OpenRemise/S3Main/README.md

# S3Main



<a href="https://openremise.at">
<picture>
  <source media="(prefers-color-scheme: dark)" srcset="https://github.com/OpenRemise/.github/raw/master/data/icons/icon_dark.svg">
  
</picture>
</a>

The S3Main is the first officially supported [OpenRemise](https://openremise.at) board.

### Features
- WiFi-capable ESP32-S3 SoC
- 10-22V DC supply
- Reverse polarity protection
- Single track output
- Adjustable current limits 0.5, 1.3, 2.7 and 4.1A
- [SUSI](https://normen.railcommunity.de/RCN-600.pdf) interface
- USB-C interface
- RailCom detector
