OpenRemise/S3Main/bom.xlsx

 |  |  | S3Main PCS BOM
Item # | *Designator | *Qty | Manufacturer | *Mfg Part # | Description / Value | *Package/Footprint | Type | Your Instructions / Notes
1 | C1,C2,C3,C7,C8,C11,C18,C29,C30,C31 | 10 | Samsung Electro-Mechanics | CL05B104KB54PNC | CAP CER 0.1UF 50V X7R 0402 | 0402 | SMD
2 | C4,C6,C19,C21,C22,C25,C26,C34 | 8 | Murata Electronics | GRM1555C2A102JE01D | CAP CER 1000PF 100V C0G/NP0 0402 | 0402 | SMD
3 | C5,C35,C36 | 3 | Murata Electronics | GCM1555C1H221JA16D | CAP CER 220PF 50V C0G/NP0 0402 | 0402 | SMD
4 | C9,C10 | 2 | Murata Electronics | GCM1555C1H101JA16D | CAP CER 100PF 50V C0G/NP0 0402 | 0402 | SMD
5 | C12,C20,C27 | 3 | Cornell Dubilier Knowles | ATB107M035E077 | CAP ALUM 100UF 20% 35V SMD | 6.60x6.60mm | SMD
6 | C13 | 1 | Murata Electronics | GRM31MR72A474KA35L | CAP CER 0.47UF 100V X7R 1206 | 1206 | SMD
7 | C14 | 1 | Samsung Electro-Mechanics | CL31B106KBHNNNE | CAP CER 10UF 50V X7R 1206 | 1206 | SMD
8 | C15,C16,C17,C23,C24 | 5 | Samsung Electro-Mechanics | CL31B105KCHVPJE | CAP CER 1UF 100V X7R 1206 | 1206 | SMD
9 | C28 | 1 | Samsung Electro-Mechanics | CL31B475KBHNFNE | CAP CER 4.7UF 50V X7R 1206 | 1206 | SMD
10 | C32 | 1 | Murata Electronics | GRT3195C2A103JA02D | CAP CER 10000PF 100V C0G 1206 | 1206 | SMD
11 | C33,C37 | 2 | TDK Corporation | C3216X7S0J476M160AC | CAP CER 47UF 6.3V X7S 1206 | 1206 | SMD
12 | D1,D2,D3,D7,D8,D11,D13,D16,D17,D19 | 10 | onsemi | 1N4148WT | SMALL SIGNAL DIODE SOD523 100V | SOD-523 | SMD
13 | D4 | 1 | SunLED | XZVG68W-2 | LED GREEN CLEAR CHIP SMD | 0402 | SMD
14 | D5 | 1 | SunLED | XZMDK68W-2 | LED RED CLEAR CHIP SMD | 0402 | SMD
15 | D6 | 1 | SunLED | XZFBA68W5MAV-3 | LED BLUE CLEAR 0402 SMD | 0402 | SMD
16 | D9 | 1 | Diotec Semiconductor | BZX84C15 | DIODE ZENER 15V 300W SOT23-3 | SOT-23-3 | SMD
17 | D10 | 1 | STMicroelectronics | ESDA6V1BC6 | TVS DIODE 5VWM SOT23-6 | SOT-23-6 | SMD
18 | D12 | 1 | Toshiba Semiconductor and Storage | CEZ30V,L3F | TVS DIODE 30VWM 47.5VC ESC | SOD-523 | SMD
19 | D14,D15 | 2 | Shenzhen Slkormicro Semicon Co., Ltd. | B5819W | 40V INDEPENDENT TYPE 900MV@3A 1A | SOD-123 | SMD
20 | D18 | 1 | Diodes Incorporated | SBR3U60P1-7 | DIODE SBR 60V 3A POWERDI123 | PowerDI™ 123 | SMD
21 | J1 | 1 | Phoenix Contact | 1844210 | TERM BLOCK HDR 2POS 90DEG 3.5MM |  | THT
22 | J2 | 1 | CNC Tech | 3020-40-0300-00 | CONN HEADER SMD 40POS 2.54MM |  | SMD
23 | J3 | 1 | Phoenix Contact | 1836189 | TERM BLOCK HDR 2POS 90DEG 5.08MM |  | THT
24 | J4 | 1 | GCT | USB4105-GF-A-120 | CONN RCP USB2.0 TYP C 24P SMD RA |  | SMD
25 | J5 | 1 | JST Sales America Inc. | SM04B-SRSS-TB | CONN HEADER SMD R/A 4POS 1MM |  | SMD
26 | L1 | 1 | Murata Electronics | LQM21PN4R7NGRD | FIXED IND 4.7UH 800MA 288MOHM SM | 0805 | SMD
27 | Q1,Q6 | 2 | Rohm Semiconductor | QS6K21TR | MOSFET 2N-CH 45V 1A TSMT6 | TSOT-23-6 | SMD
28 | Q2 | 1 | onsemi | BC847BDW1T1G | TRANS 2NPN 45V 0.1A SC88/SC70-6 | SOT-363 | SMD
29 | Q3,Q4,Q5,Q7,Q8 | 5 | Vishay Siliconix | SIS4634LDN-T1-GE3 | N-CHANNEL 60 V (D-S) MOSFET POWE | PowerPAK® 1212-8 | SMD
30 | Q9 | 1 | ANBON SEMICONDUCTOR (INT'L) LIMITED | BC847B | PLASTIC ENCAPSULATE TRANSISTORS | SOT-23-3 | SMD
31 | Q10 | 1 | onsemi | BSS138 | MOSFET N-CH 50V 220MA SOT23-3 | SOT-23-3 | SMD
32 | R1,R8,R18,R20,R34,R35,R36,R43,R50,R54 | 10 | YAGEO | RC0402FR-0710KL | RES 10K OHM 1% 1/16W 0402 | 0402 | SMD
33 | R2,R3,R4,R5 | 4 | YAGEO | RC0402FR-0722KL | RES 22K OHM 1% 1/16W 0402 | 0402 | SMD
34 | R6,R7,R31,R51 | 4 | YAGEO | RC0402FR-074K7L | RES 4.7K OHM 1% 1/16W 0402 | 0402 | SMD
35 | R9 | 1 | Vishay Dale | RCS08052R20FKEA | RES SMD 2.2 OHM 1% 1/2W 0805 | 0805 | SMD
36 | R10,R11,R14,R32,R45,R55 | 6 | YAGEO | RC0402FR-071KL | RES 1K OHM 1% 1/16W 0402 | 0402 | SMD
37 | R12,R13,R22,R26,R27 | 5 | YAGEO | RC0402FR-073K3L | RES 3.3K OHM 1% 1/16W 0402 | 0402 | SMD
38 | R15,R16,R52,R53 | 4 | YAGEO | RC0402FR-0733RL | RES 33 OHM 1% 1/16W 0402 | 0402 | SMD
39 | R17 | 1 | YAGEO | RC0402FR-07220RL | RES 220 OHM 1% 1/16W 0402 | 0402 | SMD
40 | R19,R57 | 2 |  |  |  | DNP | DNP
41 | R21 | 1 | YAGEO | RC0402FR-07100KL | RES 100K OHM 1% 1/16W 0402 | 0402 | SMD
42 | R23 | 1 | YAGEO | RC0402FR-07562RL | RES 562 OHM 1% 1/16W 0402 | 0402 | SMD
43 | R24,R25 | 2 |  |  |  | DNP | DNP
44 | R28 | 1 | YAGEO | RC0402FR-07422RL | RES 422 OHM 1% 1/16W 0402 | 0402 | SMD
45 | R29,R30,R46,R49 | 4 | YAGEO | RC0402FR-0747RL | RES 47 OHM 1% 1/16W 0402 | 0402 | SMD
46 | R33 | 1 | YAGEO | RC0402FR-07180RL | RES 180 OHM 1% 1/16W 0402 | 0402 | SMD
47 | R37,R44,R47 | 3 | YAGEO | RC0402FR-0714K3L | RES 14.3K OHM 1% 1/16W 0402 | 0402 | SMD
48 | R38,R48 | 2 | YAGEO | RC0402FR-07470RL | RES 470 OHM 1% 1/16W 0402 | 0402 | SMD
49 | R39 | 1 | YAGEO | RC0402FR-0718K7L | RES 18.7K OHM 1% 1/16W 0402 | 0402 | SMD
50 | R40,R41 | 2 | YAGEO | RC0402FR-075K1L | RES 5.1K OHM 1% 1/16W 0402 | 0402 | SMD
51 | R42 | 1 | YAGEO | RC0402FR-0739KL | RES 39K OHM 1% 1/16W 0402 | 0402 | SMD
52 | R56 | 1 | Panasonic Electronic Components | ERJ-PA2J221X | RES 220 OHM 5% 1/4W 0402 | 0402 | SMD
53 | SW1, SW2 | 2 | Panasonic Electronic Components | EVP-BFAC1A000 | SWITCH TACTILE SPST-NO 0.02A 15V | 6.00x6.00mm | SMD
54 | U1 | 1 | onsemi | LM393EDR2G | IC COMPARATOR 2 GEN PUR 8SOIC | 8-SOIC | SMD
55 | U2 | 1 | Nexperia USA Inc. | 74LVC02APW,118 | IC GATE NOR 4CH 2-INP 14TSSOP | 14-TSSOP | SMD
56 | U3 | 1 | Texas Instruments | TLV9051IDBVR | IC OPAMP GP 1 CIRCUIT SOT23-5 | SOT23-5 | SMD
57 | U4 | 1 | Espressif Systems | ESP32-S3-WROOM-2-N32R16V | RF TXRX MOD BT WIFI PCB TH SMD |  | SMD
58 | U5 | 1 | Texas Instruments | DRV8328BRUYR | 60 V 1000/2000 MA 3-PHASE GATE D | 28-WQFN | SMD
59 | U6 | 1 | Texas Instruments | TPS281C100ADNTR | 6-V TO 60-V, 100-M, 4.5-A SINGLE | 12-WSON | SMD
60 | U7 | 1 | Diodes Incorporated | AP63205WU-7 | IC REG BUCK 5V 2A TSOT23-6 | SOT-23-6 | SMD
61 | U8 | 1 | Texas Instruments | TXS0102DCTR | IC TRANSLATOR BIDIRECTIONAL SM8 | 8-SSOP | SMD
62 | U9 | 1 | Diodes Incorporated | AZ1117CR-3.3TRG1 | IC REG LINEAR 3.3V 1A SOT89 | SOT-89-3 | SMD
63 | U10 | 1 | Infineon Technologies | BTS4141NHUMA1 | IC PWR SWTCH N-CHAN 1:1 SOT223-4 | SOT223-4 | SMD
