OpenRemise/S3Main/s3main.kicad_pcb

## KiCad design s3main.kicad_pcb (2026-06-04)

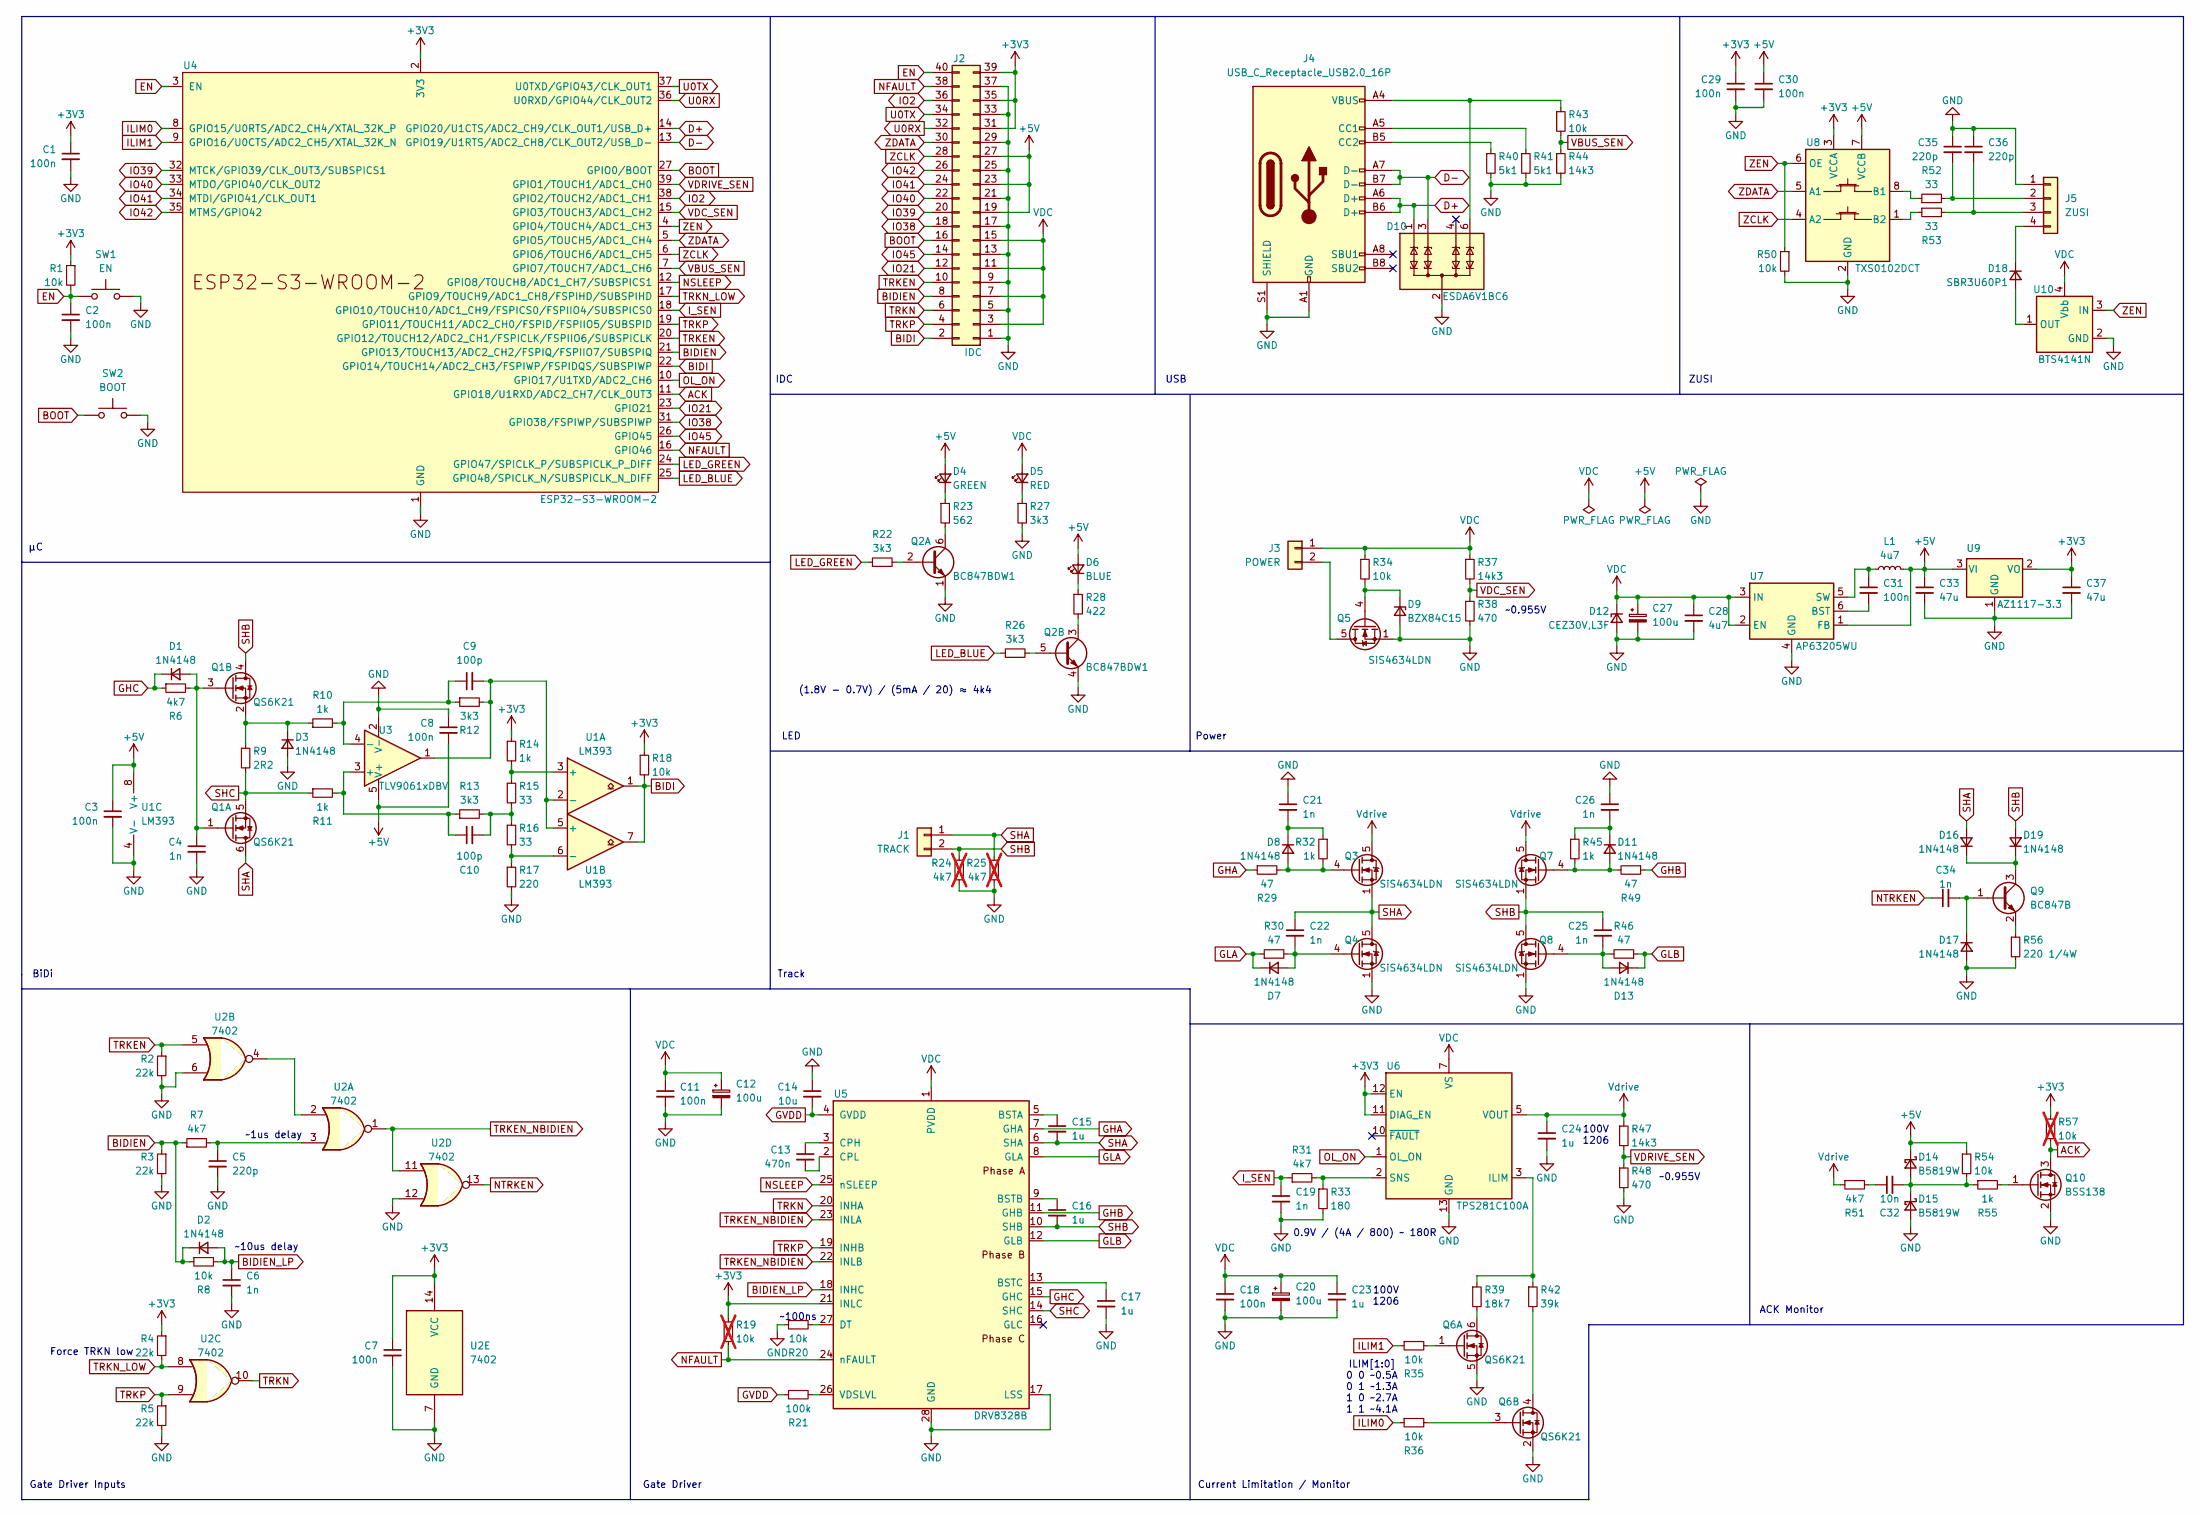
[picture p1: schematic s3main.kicad_sch]

Parts:
C1, C2, C3, C7, C8, C11, C18, C29, C30, C31: 100n; C_0402_1005Metric
C4, C6, C19, C21, C22, C25, C26, C34: 1n; C_0402_1005Metric
C5, C35, C36: 220p; C_0402_1005Metric
C9, C10: 100p; C_0402_1005Metric
C12, C20, C27: 100u; CP_Elec_6.3x7.7
C13: 470n; C_1206_3216Metric
C14: 10u; C_1206_3216Metric
C15, C16, C17, C23, C24: 1u; C_1206_3216Metric
C28: 4u7; C_1206_3216Metric
C32: 10n; C_1206_3216Metric
C33, C37: 47u; C_1206_3216Metric
D1, D2, D3, D7, D8, D11, D13, D16, D17, D19: 1N4148; D_SOD-523
D4: GREEN; D_0402_1005Metric
D5: RED; D_0402_1005Metric
D6: BLUE; D_0402_1005Metric
D9: BZX84C15; SOT-23
D10: ESDA6V1BC6; SOT-23-6
D12: CEZ30V,L3F; D_SOD-523
D14, D15: B5819W; D_SOD-123
D18: SBR3U60P1; D_PowerDI-123
J1: TRACK; PhoenixContact_MC_1,5_2-G-3.5_1x02_P3.50mm_Horizontal
J2: IDC; IDC-Header_2x20_P2.54mm_Vertical_SMD
J3: POWER; PhoenixContact_MC_1,5_2-G-5.08_1x02_P5.08mm_Horizontal
J4: USB_C_Receptacle_USB2.0_16P; USB_C_Receptacle_GCT_USB4105-xx-A_16P_TopMnt_Horizontal
J5: ZUSI; JST_SH_SM04B-SRSS-TB_1x04-1MP_P1.00mm_Horizontal
L1: 4u7; L_0805_2012Metric
Q1, Q6: QS6K21; TSOT-23-6
Q2: BC847BDW1; SOT-363_SC-70-6
Q3, Q4, Q5, Q7, Q8: SiS4634LDN; Vishay_PowerPAK_1212-8_Single
Q9: BC847B; SOT-23
Q10: BSS138; SOT-23
R1, R8, R18, R20, R34, R35, R36, R43, R50, R54: 10k; R_0402_1005Metric
R2, R3, R4, R5: 22k; R_0402_1005Metric
R6, R7, R31, R51: 4k7; R_0402_1005Metric
R9: 2R2; R_0805_2012Metric_Pad1.20x1.40mm_HandSolder
R10, R11, R14, R32, R45, R55: 1k; R_0402_1005Metric
R12, R13, R22, R26, R27: 3k3; R_0402_1005Metric
R15, R16, R52, R53: 33; R_0402_1005Metric
R17: 220; R_0402_1005Metric
R19, R57: 10k; R_0402_1005Metric; not fitted
R21: 100k; R_0402_1005Metric
R23: 562; R_0402_1005Metric
R24, R25: 4k7; R_0805_2012Metric_Pad1.20x1.40mm_HandSolder; not fitted
R28: 422; R_0402_1005Metric
R29, R30, R46, R49: 47; R_0402_1005Metric
R33: 180; R_0402_1005Metric
R37, R44, R47: 14k3; R_0402_1005Metric
R38, R48: 470; R_0402_1005Metric
R39: 18k7; R_0402_1005Metric
R40, R41: 5k1; R_0402_1005Metric
R42: 39k; R_0402_1005Metric
R56: 220 1/4W; R_0402_1005Metric
SW1: EN; SW_SPST_EVPBF
SW2: BOOT; SW_SPST_EVPBF
U1: LM393; SOIC-8_3.9x4.9mm_P1.27mm
U2: 7402; TSSOP-14_4.4x5mm_P0.65mm
U3: TLV9061xDBV; SOT-23-5
U4: ESP32-S3-WROOM-2
U5: DRV8328B; QFN-28-1EP_4x4mm_P0.4mm_EP2.6x2.6mm_ThermalVias
U6: TPS281C100A; WSON-12-1EP_4x4mm_P0.5mm_EP2.6x3mm_ThermalVias
U7: AP63205WU; TSOT-23-6
U8: TXS0102DCT; SSOP-8_2.95x2.8mm_P0.65mm
U9: AZ1117-3.3; SOT-89-3
U10: BTS4141N; SOT-223

Connections:
+3V3: C1.1, C7.1, C29.1, C37.1, J2.31, J2.35, J2.39, R1.1, R4.1, R14.1, R18.1, R19.1, R57.1, U2.14 (VCC), U4.2 (3V3), U5.21 (INLC), U6.11 (DIAG_EN), U6.12 (EN), U8.3 (VCCA), U9.2 (VO)
+5V: C3.1, C8.2, C30.1, C33.1, D4.2 (A), D6.2 (A), D14.1 (K), J2.19, J2.23, J2.27, L1.2, R54.1, U1.8 (V+), U3.5 (V+), U7.1 (FB), U8.7 (VCCB), U9.3 (VI)
ACK: Q10.3 (D), R57.2, U4.11 (GPIO18/U1RXD/ADC2_CH7/CLK_OUT3)
BIDI: J2.2, R18.2, U1.1, U1.7, U4.22 (GPIO14/TOUCH14/ADC2_CH3/FSPIWP/FSPIDQS/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)
BIDIEN: D2.1 (K), J2.8, R3.1, R7.1, R8.1, U4.21 (GPIO13/TOUCH13/ADC2_CH2/FSPIQ/FSPIIO7/S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)
BIDIEN_LP: C6.1, D2.2 (A), R8.2, U5.18 (INHC)
BOOT: J2.16, SW2.1, U4.27 (GPIO0/BOOT)
D+: D10.1 (TVS1), J4.A6 (D+), J4.B6 (D+), U4.14 (GPIO20/U1CTS/ADC2_CH9/CLK_OUT1/USB_D+)
D-: D10.3 (TVS2), J4.A7 (D-), J4.B7 (D-), U4.13 (GPIO19/U1RTS/ADC2_CH8/CLK_OUT2/USB_D-)
EN: C2.1, J2.40, R1.2, SW1.1, U4.3 (EN)
GHA: R29.1, U5.7 (GHA)
GHB: R49.1, U5.11 (GHB)
GHC: D1.1 (K), R6.1, U5.15 (GHC)
GLA: D7.1 (K), R30.1, U5.8 (GLA)
GLB: D13.1 (K), R46.1, U5.12 (GLB)
GND: C1.2, C2.2, C3.2, C4.2, C5.2, C6.2, C7.2, C8.1, C11.2, C12.2, C14.1, C17.2, C18.2, C19.2, C20.2, C21.1, C23.2, C24.2, C26.1, C27.2, C28.2, C29.2, C30.2, C33.2, C35.1, C36.1, C37.2, D3.2 (A), D9.2 (A), D10.2 (COM), D10.5 (COM), D12.2 (A), D15.2 (A), D17.2 (A), J2.1, J2.5, J2.9, J2.13, J2.17, J2.21, J2.25, J2.29, J2.33, J2.37, J4.A1 (GND), J4.A12 (GND), J4.B1 (GND), J4.B12 (GND), J4.S1 (SHIELD), J5.1, Q2.1 (E1), Q2.4 (E2), Q4.1 (S), Q4.2 (S), Q4.3 (S), Q5.1 (S), Q5.2 (S), Q5.3 (S), Q6.2 (S), Q6.5 (S), Q8.1 (S), Q8.2 (S), Q8.3 (S), Q10.2 (S), R2.2, R3.2, R5.2, R17.2, R20.1, R24.2, R25.2, R27.2, R33.2, R38.2, R40.2, R41.2, R44.2, R48.2, R50.2, R56.2, SW1.2, SW2.2, U1.4 (V-), U2.6, U2.7 (GND), U2.12, U3.2 (V-), U4.1 (GND), U4.40 (GND), U4.41 (GND), U5.17 (LSS), U5.28 (GND), U5.29 (GND), U6.13 (GND), U7.4 (GND), U8.2 (GND), U9.1 (GND), U10.2 (GND)
GVDD: C14.2, R21.1, U5.4 (GVDD)
ILIM0: R36.1, U4.8 (GPIO15/U0RTS/ADC2_CH4/XTAL_32K_P)
ILIM1: R35.1, U4.9 (GPIO16/U0CTS/ADC2_CH5/XTAL_32K_N)
IO2: J2.36, U4.38 (GPIO2/TOUCH2/ADC1_CH1)
IO21: J2.12, U4.23 (GPIO21)
IO38: J2.18, U4.31 (GPIO38/FSPIWP/SUBSPIWP)
IO39: J2.20, U4.32 (MTCK/GPIO39/CLK_OUT3/SUBSPICS1)
IO40: J2.22, U4.33 (MTDO/GPIO40/CLK_OUT2)
IO41: J2.24, U4.34 (MTDI/GPIO41/CLK_OUT1)
IO42: J2.26, U4.35 (MTMS/GPIO42)
IO45: J2.14, U4.26 (GPIO45)
I_SEN: C19.1, R31.1, U4.18 (GPIO10/TOUCH10/ADC1_CH9/FSPICS0/FSPIIO4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)
LED_BLUE: R26.1, U4.25 (GPIO48/SPICLK_N/SUBSPICLK_N_DIFF)
LED_GREEN: R22.1, U4.24 (GPIO47/SPICLK_P/SUBSPICLK_P_DIFF)
NFAULT: J2.38, R19.2, U4.16 (GPIO46), U5.24 (nFAULT)
NSLEEP: U4.12 (GPIO8/TOUCH8/ADC1_CH7/SUBSPICS1), U5.25 (nSLEEP)
NTRKEN: C34.1, U2.13
unnamed: C5.1, R7.2, U2.3
unnamed: C10.2, R13.2, R15.2, R16.1
unnamed: C32.1, R51.2
unnamed: C4.1, D1.2 (A), Q1.1 (G), Q1.3 (G), R6.2
unnamed: D3.1 (K), Q1.2 (S), R9.1, R10.1
unnamed: D4.1 (K), R23.1
unnamed: D5.1 (K), R27.1
unnamed: D6.1 (K), R28.1
unnamed: C22.2, D7.2 (A), Q4.4 (G), R30.2
unnamed: D8.2 (A), Q3.4 (G), R29.2, R32.2
unnamed: C21.2, D8.1 (K), R32.1
unnamed: D9.1 (K), Q5.4 (G), R34.2
unnamed: D10.6 (TVS4), J4.A4 (VBUS), J4.A9 (VBUS), J4.B4 (VBUS), J4.B9 (VBUS), R43.1
unnamed: D11.2 (A), Q7.4 (G), R45.2, R49.2
unnamed: C26.2, D11.1 (K), R45.1
unnamed: C25.2, D13.2 (A), Q8.4 (G), R46.2
unnamed: C32.2, D14.2 (A), D15.1 (K), R54.2, R55.1
unnamed: D16.1 (K), D19.1 (K), Q9.3 (C)
unnamed: C34.2, D17.1 (K), Q9.1 (B)
unnamed: D18.2 (A), U10.1 (OUT)
unnamed: D18.1 (K), J5.4
unnamed: J3.2, Q5.5 (D)
unnamed: J4.A5 (CC1), R41.1
unnamed: J4.B5 (CC2), R40.1
unnamed: C35.2, J5.2, R52.2
unnamed: C36.2, J5.3, R53.2
unnamed: Q2.2 (B1), R22.2
unnamed: Q2.6 (C1), R23.2
unnamed: Q2.5 (B2), R26.2
unnamed: Q2.3 (C2), R28.2
unnamed: Q6.6 (D), R39.2
unnamed: Q6.1 (G), R35.2
unnamed: Q6.4 (D), R42.2
unnamed: Q6.3 (G), R36.2
unnamed: Q9.2 (E), R56.1
unnamed: Q10.1 (G), R55.2
unnamed: R14.2, R15.1, U1.3 (+)
unnamed: C9.2, R12.2, U1.2 (-), U1.5 (+), U3.1
unnamed: R16.2, R17.1, U1.6 (-)
unnamed: U2.2, U2.4
unnamed: C10.1, R11.2, R13.1, U3.3 (+)
unnamed: C9.1, R10.2, R12.1, U3.4 (-)
unnamed: C15.1, U5.5 (BSTA)
unnamed: C16.1, U5.9 (BSTB)
unnamed: C17.1, U5.13 (BSTC)
unnamed: C13.1, U5.3 (CPH)
unnamed: C13.2, U5.2 (CPL)
unnamed: R20.2, U5.27 (DT)
unnamed: R21.2, U5.26 (VDSLVL)
unnamed: R39.1, R42.1, U6.3 (ILIM)
unnamed: R31.2, R33.1, U6.2 (SNS)
unnamed: C31.2, U7.6 (BST)
unnamed: C31.1, L1.1, U7.5 (SW)
unnamed: R52.1, U8.8 (B1)
unnamed: R53.1, U8.1 (B2)
OL_ON: U4.10 (GPIO17/U1TXD/ADC2_CH6), U6.1 (OL_ON)
SHA: C15.2, C22.1, D16.2 (A), J1.1, Q1.6 (D), Q3.1 (S), Q3.2 (S), Q3.3 (S), Q4.5 (D), R25.1, U5.6 (SHA)
SHB: C16.2, C25.1, D19.2 (A), J1.2, Q1.4 (D), Q7.1 (S), Q7.2 (S), Q7.3 (S), Q8.5 (D), R24.1, U5.10 (SHB)
SHC: Q1.5 (S), R9.2, R11.1, U5.14 (SHC)
TRKEN: J2.10, R2.1, U2.5, U4.20 (GPIO12/TOUCH12/ADC2_CH1/FSPICLK/FSPIIO6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)
TRKEN_NBIDIEN: U2.1, U2.11, U5.22 (INLB), U5.23 (INLA)
TRKN: J2.6, U2.10, U5.20 (INHA)
TRKN_LOW: R4.2, U2.8, U4.17 (GPIO9/TOUCH9/ADC1_CH8/FSPIHD/SUBSPIHD)
TRKP: J2.4, R5.1, U2.9, U4.19 (GPIO11/TOUCH11/ADC2_CH0/FSPID/FSPIIO5/S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), U5.19 (INHB)
U0RX: J2.32, U4.36 (U0RXD/GPIO44/CLK_OUT2)
U0TX: J2.34, U4.37 (U0TXD/GPIO43/CLK_OUT1)
VBUS_SEN: R43.2, R44.1, U4.7 (GPIO7/TOUCH7/ADC1_CH6)
VDC: C11.1, C12.1, C18.1, C20.1, C23.1, C27.1, C28.1, D5.2 (A), D12.1 (K), J2.3, J2.7, J2.11, J2.15, J3.1, R34.1, R37.1, U5.1 (PVDD), U6.7 (VS), U6.8 (VS), U7.2 (EN), U7.3 (IN), U10.4 (Vbb)
VDC_SEN: R37.2, R38.1, U4.15 (GPIO3/TOUCH3/ADC1_CH2)
VDRIVE_SEN: R47.2, R48.1, U4.39 (GPIO1/TOUCH1/ADC1_CH0)
Vdrive: C24.1, Q3.5 (D), Q7.5 (D), R47.1, R51.1, U6.5 (VOUT), U6.6 (VOUT)
ZCLK: J2.28, U4.6 (GPIO6/TOUCH6/ADC1_CH5), U8.4 (A2)
ZDATA: J2.30, U4.5 (GPIO5/TOUCH5/ADC1_CH4), U8.5 (A1)
ZEN: R50.1, U4.4 (GPIO4/TOUCH4/ADC1_CH3), U8.6 (OE), U10.3 (IN)

Notes on the sheet:
Force TRKN low
~1us delay
IDC
~0.955V
100V 1206
0.9V / (4A / 800) ~ 180R
Gate Driver
ZUSI
ILIM[1:0] 0 0 ~0.5A 0 1 ~1.3A 1 0 ~2.7A 1 1 ~4.1A
LED
Gate Driver Inputs
BiDi
USB
~100ns
Current Limitation / Monitor
Track
(1.8V - 0.7V) / (5mA / 20) ≈ 4k4
Power
~10us delay
ACK Monitor

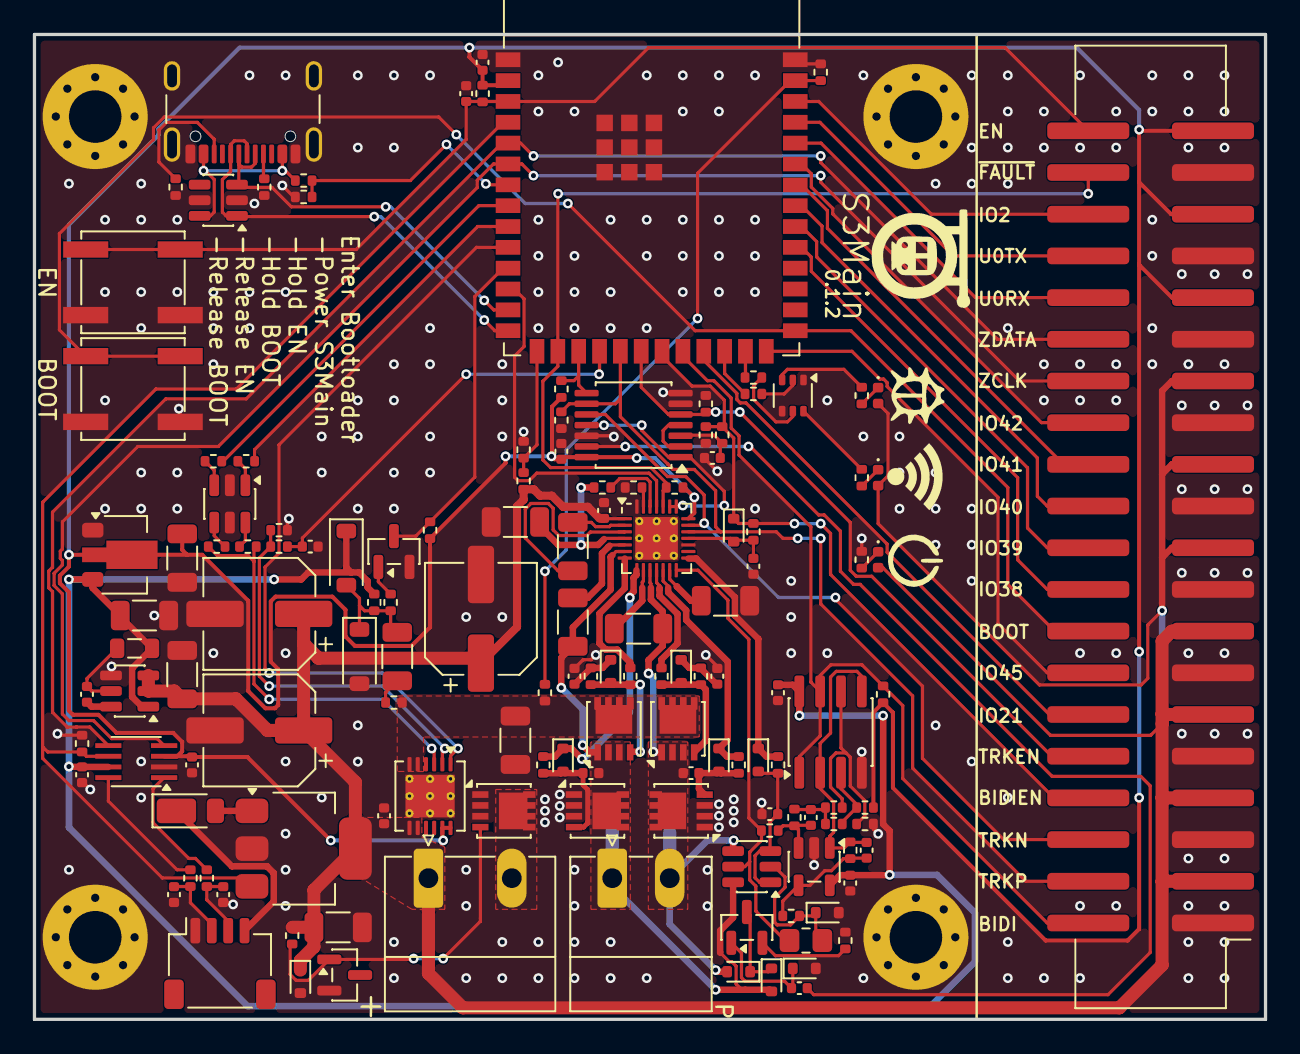
[picture p2: board s3main.kicad_pcb from above]

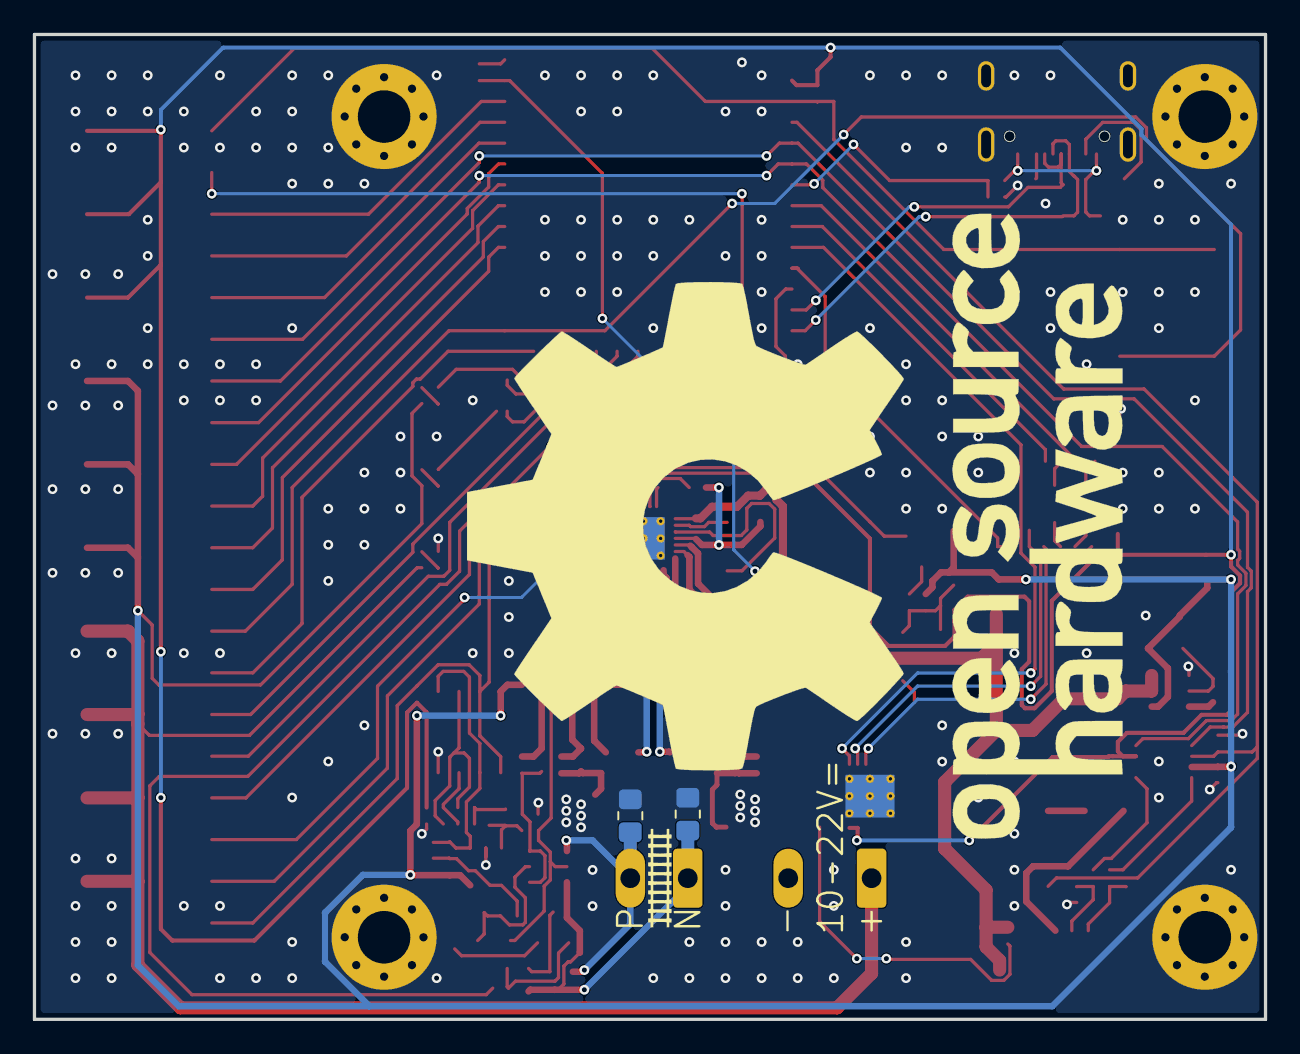
[picture p3: board s3main.kicad_pcb from below]

Board: 2 copper layers, 75.0 x 60.0 mm, 141 parts (2 on the bottom side), 107 nets.
