OpenRemise/S3Main/CHANGELOG.md

# Changelog

## 0.1.2
- Replace IO2 with VDRIVE_SEN
- Revert replace ACK circuit with TPS281C100 fault pin

## 0.1.1
- Replace ACK circuit with TPS281C100 fault pin

## 0.1.0
- Initial version
