OpenRemise/S3Main/(commit log)

2024-11-15 feat: revision A
    [bom.xlsx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]
2024-11-19 chore: remove R24 and R25 part number and designator in BOM
    [bom.xlsx]
2024-11-27 chore: DNP R19
    [bom.xlsx, s3main.kicad_sch]
2024-11-27 chore: switch to semantic versioning
    [s3main.kicad_pcb]
2024-12-20 feat: new ACK circuit
    [s3main.kicad_pcb, s3main.kicad_sch]
2024-12-21 feat: update BOM
    [bom.xlsx, s3main.kicad_pcb]
2024-12-21 feat: update gerber
    [s3main-B_Cu.gbl, s3main-B_Mask.gbs, s3main-B_Paste.gbp, s3main-B_Silkscreen.gbo, s3main-Edge_Cuts.gm1, s3main-F_Cu.gtl, s3main-F_Mask.gts, s3main-F_Paste.gtp]
2025-02-25 build: update to KiCad 9.0.0
    [s3main.kicad_pcb, s3main.kicad_sch]
2025-02-25 fix: rule "Pad Size"
    [s3main.kicad_pcb]
2025-12-14 chore: replace ACK circuit with TPS281C100 fault pin
    [bom.xlsx, s3main.kicad_pcb, s3main.kicad_sch]
2026-02-07 revert: chore: replace ACK circuit with TPS281C100 fault pin
    [bom.xlsx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]
2026-02-10 feat: replace IO2 with VDRIVE_SEN
    [bom.xlsx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]
2026-03-22 build: update to KiCad 10.0.0
    [s3main.kicad_pcb, s3main.kicad_sch]
2026-06-01 chore: update BOM (B5819W manufacturer)
    [bom.xlsx]
2026-06-04 chore: use consistent SOT-23-3 footprint
    [bom.xlsx, s3main.kicad_pcb, s3main.kicad_sch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]
